DyrbiBOY/hellen-example_DK/boards/uefi2-A0/board/misc/uefi2-A0-bottom.png

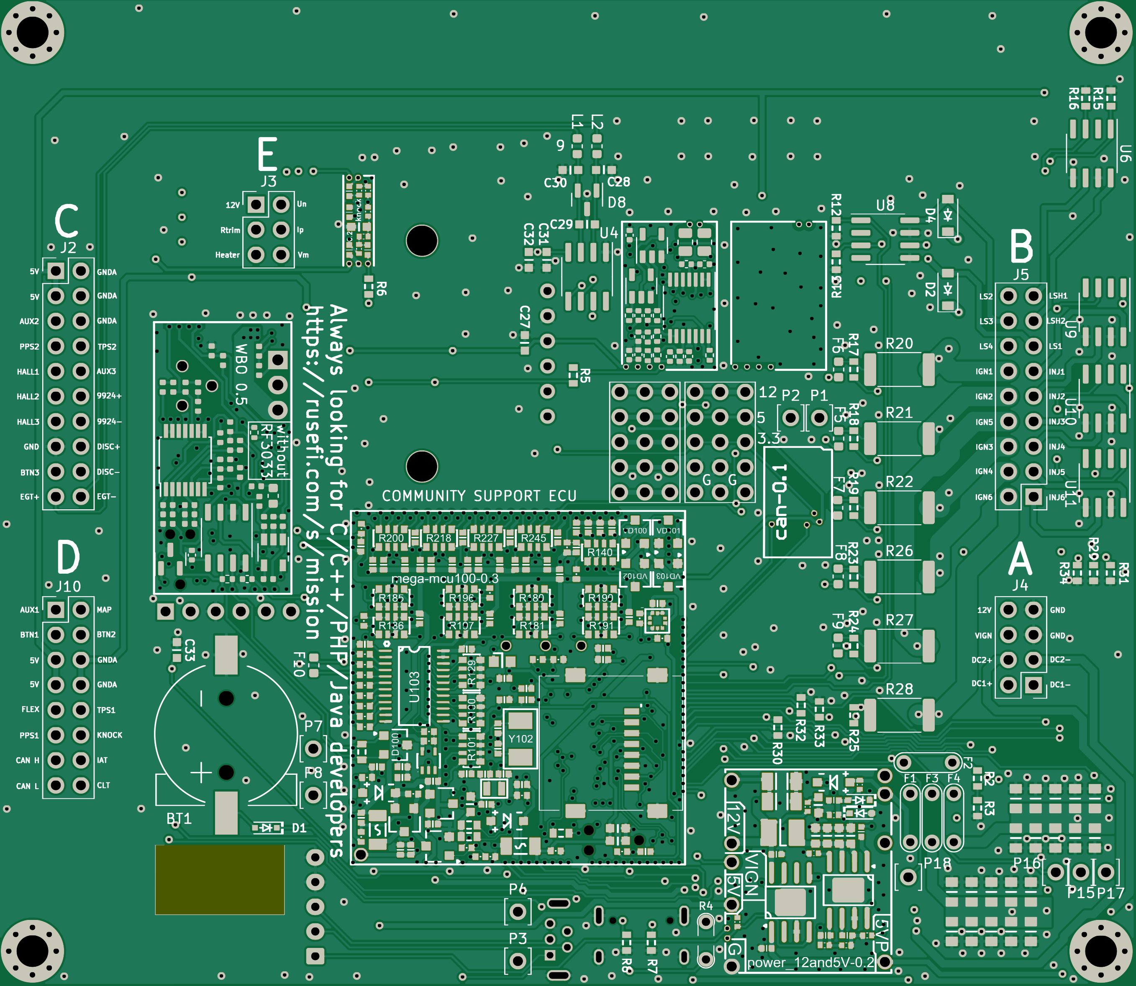
boards/uefi2-A0/board/misc/uefi2-A0-bottom.png
