DyrbiBOY/hellen-example_DK/boards/uefi2-A0/board/uefi2-A0.png

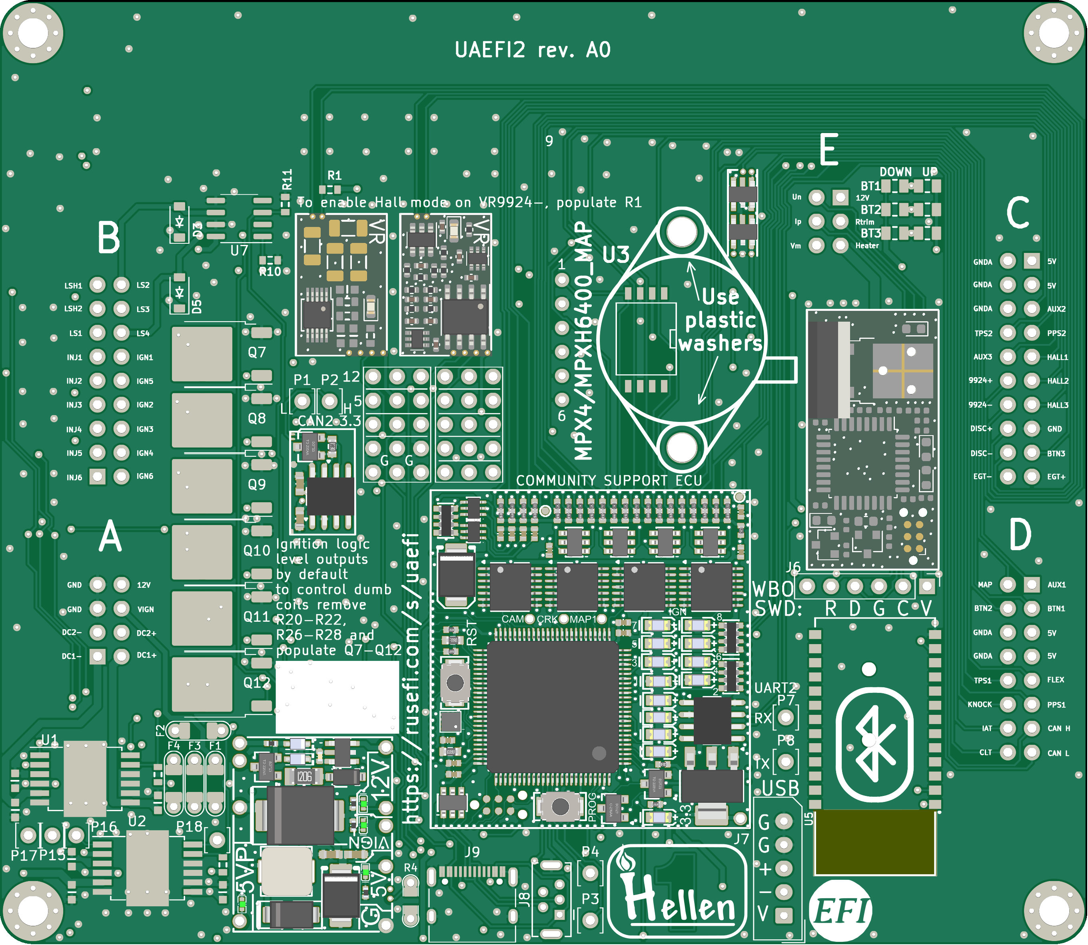
boards/uefi2-A0/board/uefi2-A0.png
