DyrbiBOY/hellen-example_DK/boards/uefi2-a/board/misc/uefi2-a-outline.png

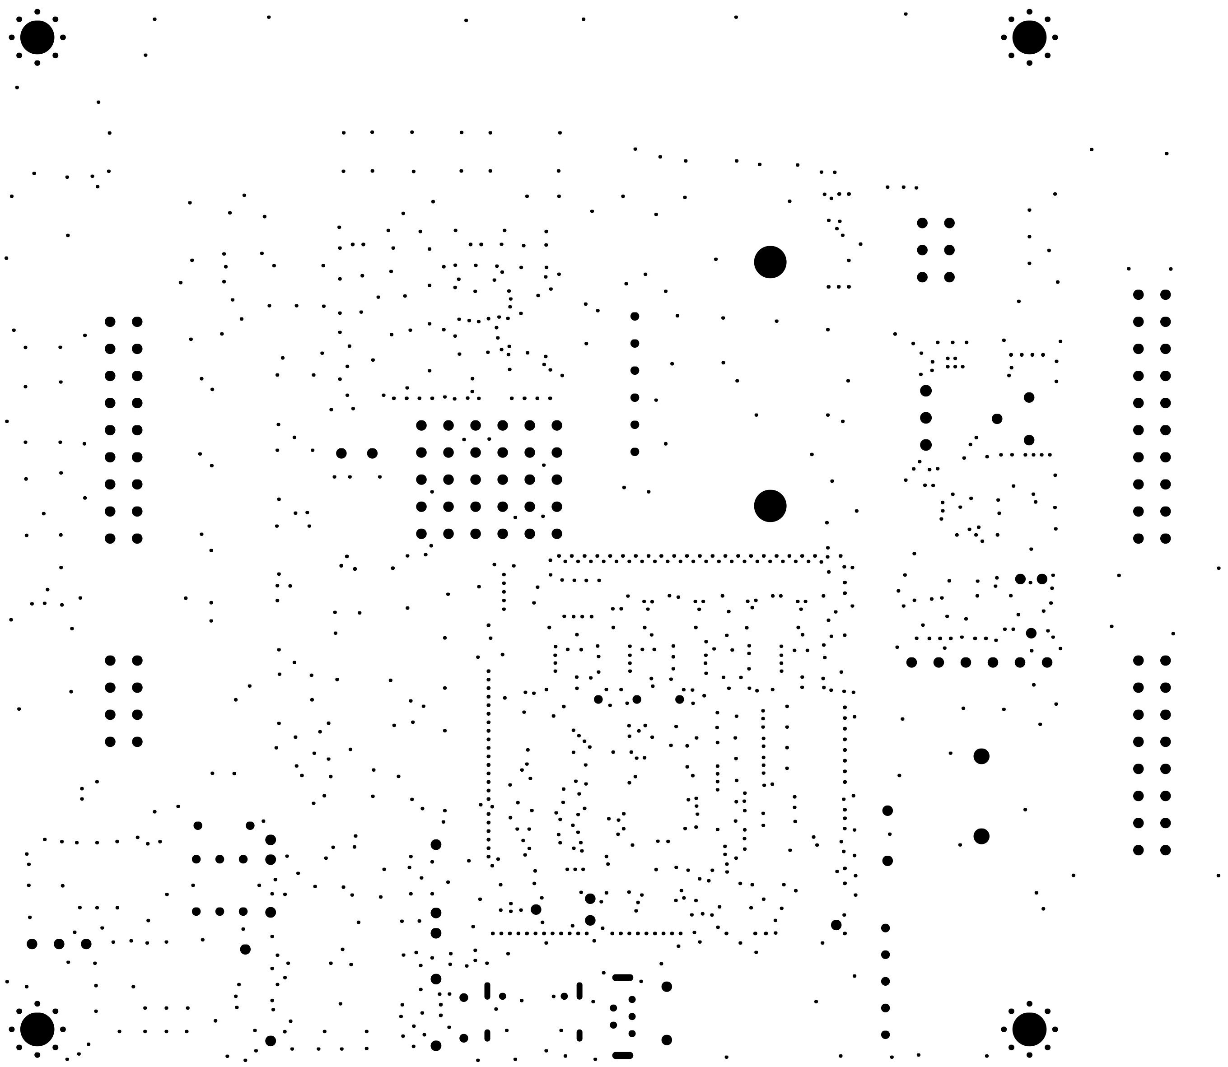
boards/uefi2-a/board/misc/uefi2-a-outline.png
