DyrbiBOY/hellen-example_DK/boards/uefi2-a/board/misc/uefi2-a-top.png

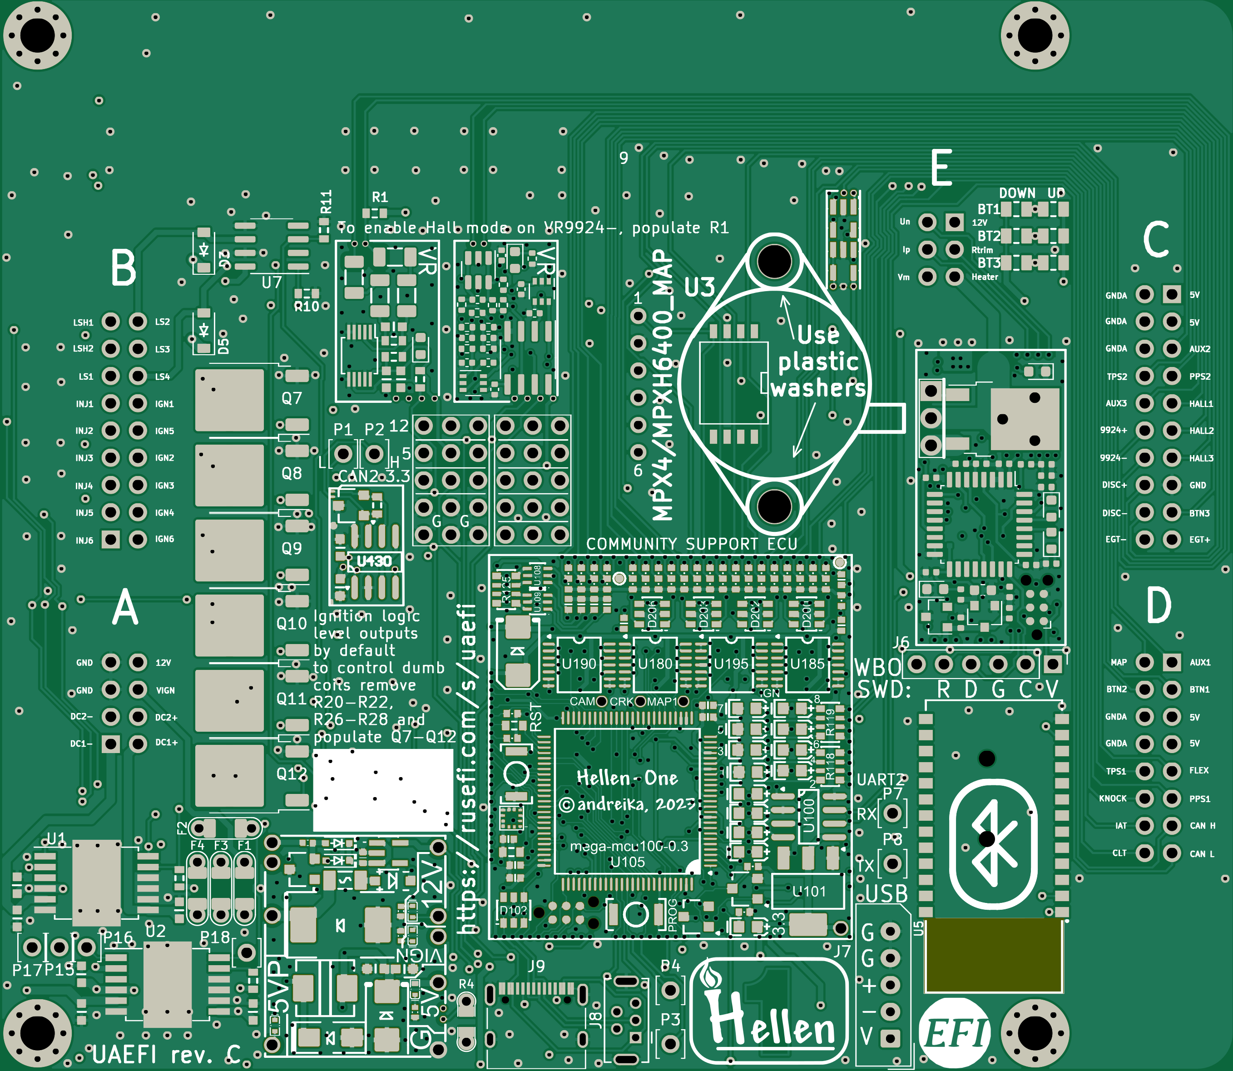
boards/uefi2-a/board/misc/uefi2-a-top.png
