DyrbiBOY/hellen-example_DK/boards/uefi2-a/board/uefi2-a.png

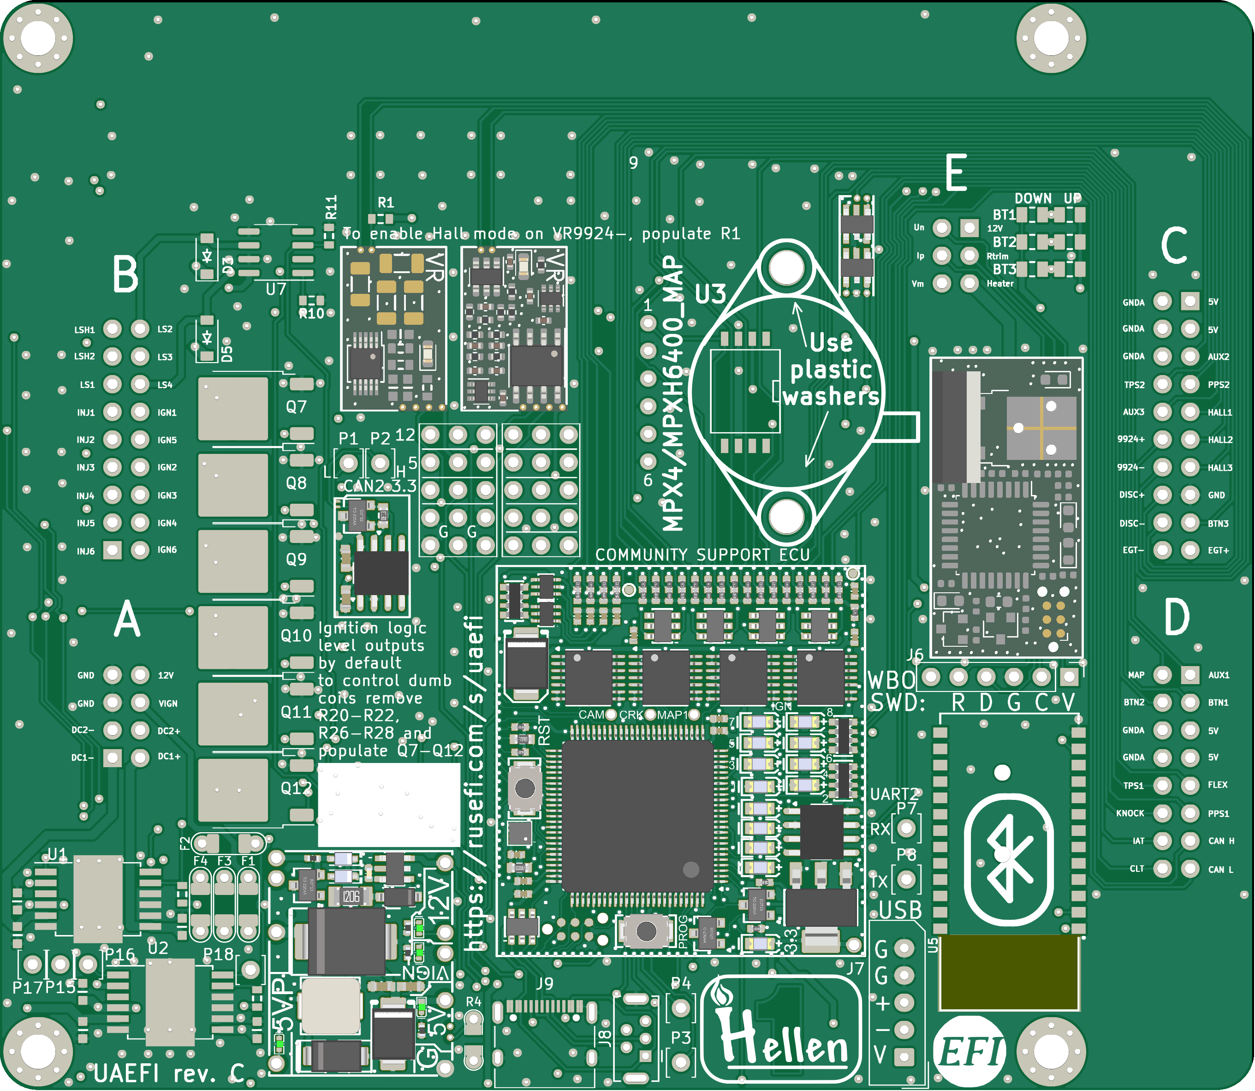
boards/uefi2-a/board/uefi2-a.png
