DyrbiBOY/hellen-example_DK/boards/uefi2-A0/board/misc/uefi2-A0-components.png

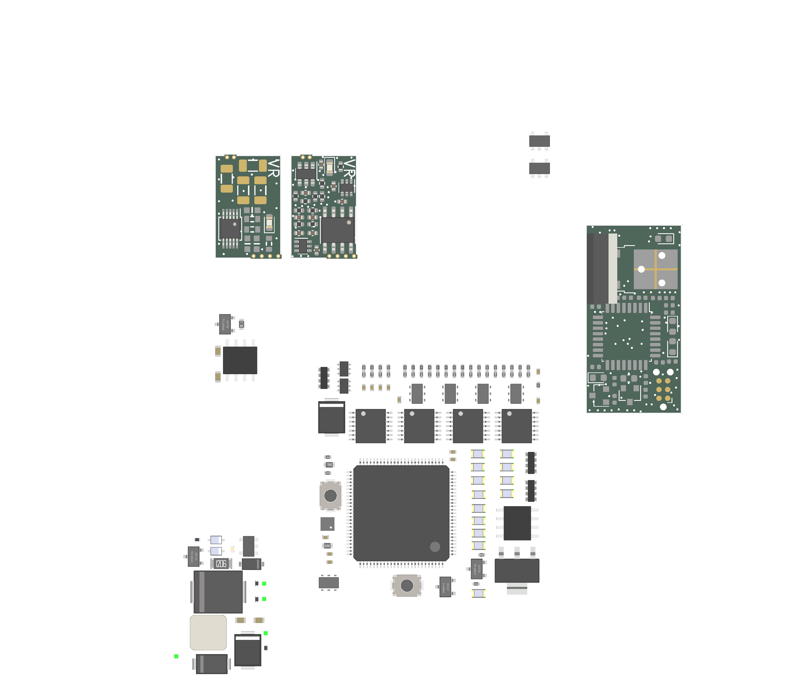
boards/uefi2-A0/board/misc/uefi2-A0-components.png
