DyrbiBOY/hellen-example_DK/boards/uefi2-A0/frame/fi2-schematic.pdf

Discrete inputs DC Motor #0

J4 Conn_02x04_Odd_Even
instead of the knock signal A

3V3 12 GND 13 EN 15 ALED 16 STAT 17 RXD 2

enable the CAN WAKEUP

analog signal VR-DISCRETE

https://rusefi.com/s/uaefi
File: uefi2.kicad_sch Sheet: / rusEFI.com



Id: 3/9 Title: File: LS4.kicad_sch Sheet: /LS/ GND




Id: 8/9 Title: File: MAP.kicad_sch Sheet: /MAP/


Id: 9/9 Title: File: IGN6.kicad_sch Sheet: /Ignition/ R28


Id: 9/9 Title: File: egt.kicad_sch Sheet: /EGT/ GND
