DyrbiBOY/hellen-example_DK/(commit log)

2024-10-18 [skip actions] Auto-generated board v2.1
    [uefi2-B_Cu.gbl, uefi2-B_Mask.gbs, uefi2-B_Paste.gbp, uefi2-B_Silkscreen.gbo, uefi2-Edge_Cuts.gm1, uefi2-F_Cu.gtl, uefi2-F_Mask.gts, uefi2-F_Paste.gtp]
2024-10-18 add bom_replace_uefi2-a
    [bom_replace_uefi2-a.csv, bom_replace_xxxyyy-a.csv]
2024-11-12 change revision from a to A0, change kicad file
    [bom_replace_uefi2-A0.csv, uefi2.kicad_pcb, uefi2.kicad_sch]
2024-12-02 GHA says update kicad6-libraries
